mgosselin/gppr/images/scope_screen_captures/breadboard_prototype/raw_images/IMG_20190705_214928.jpg

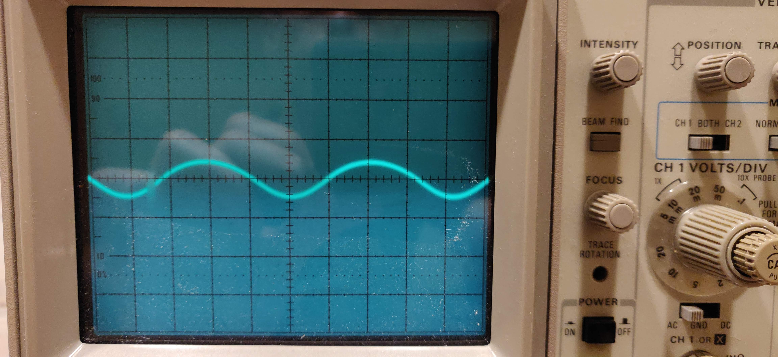
images/scope_screen_captures/breadboard_prototype/raw_images/IMG_20190705_214928.jpg
