mgosselin/gppr/images/lt_spice_screen_shots/circuit/Screen Shot 2019-07-04 at 11.34.25 PM.png

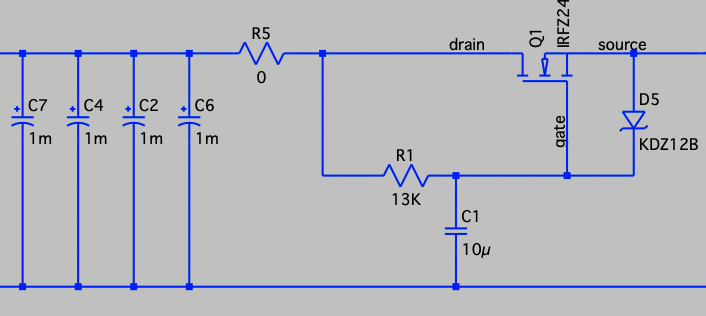
images/lt_spice_screen_shots/circuit/Screen Shot 2019-07-04 at 11.34.25 PM.png
