mgosselin/gppr/images/lt_spice_screen_shots/plots/spectrum_showing_all_freqs.png

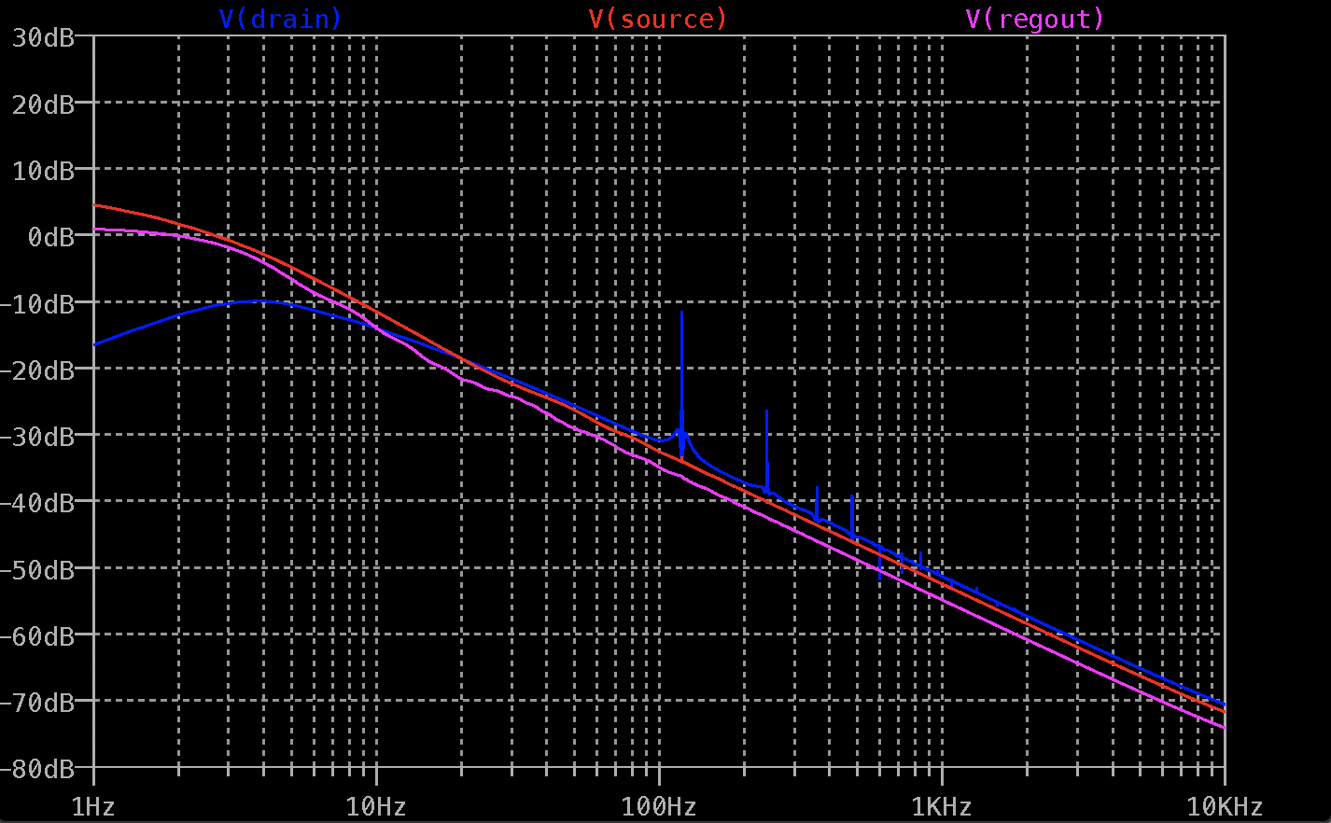
images/lt_spice_screen_shots/plots/spectrum_showing_all_freqs.png
