mgosselin/gppr/images/lt_spice_screen_shots/plots/spectrum_showing_harmonics.png

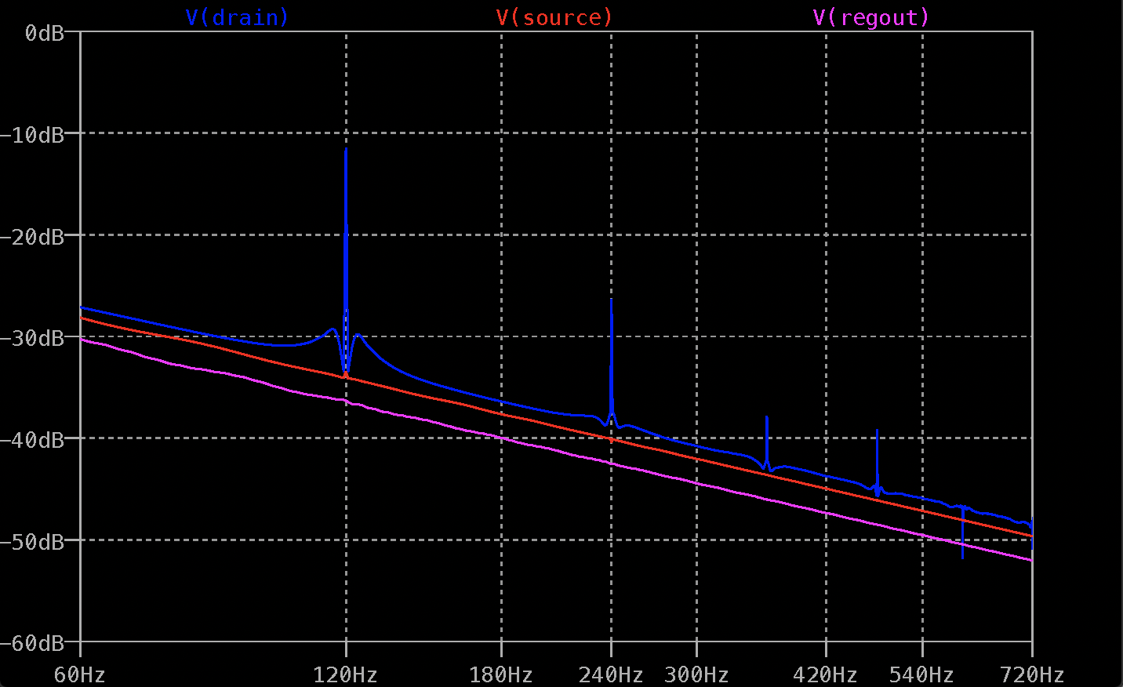
images/lt_spice_screen_shots/plots/spectrum_showing_harmonics.png
