mgosselin/gppr/images/lt_spice_screen_shots/plots/spectrum_showing_main_mode.png

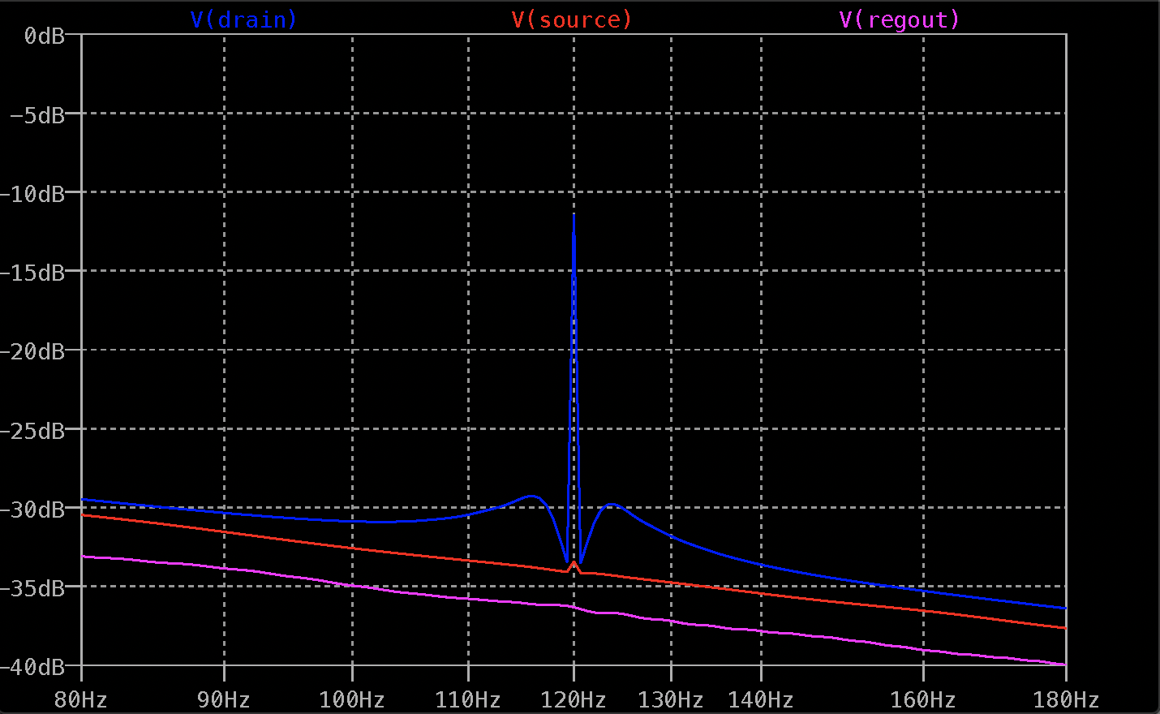
images/lt_spice_screen_shots/plots/spectrum_showing_main_mode.png
