mgosselin/gppr/images/lt_spice_screen_shots/plots/transient_all_nodes.png

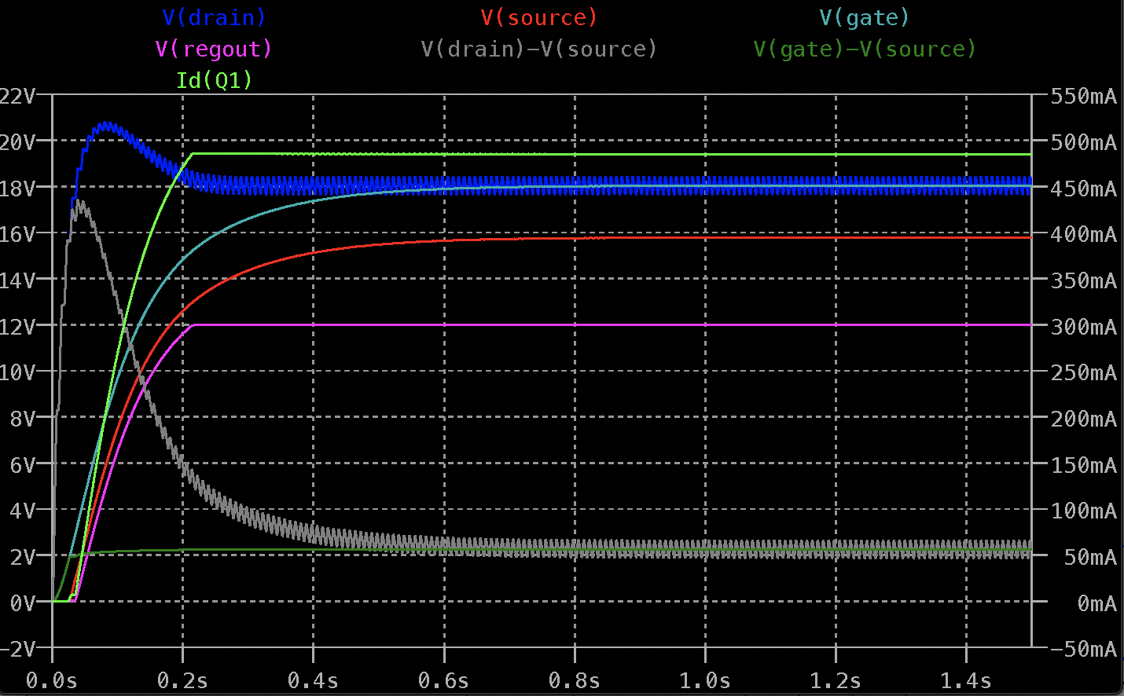
images/lt_spice_screen_shots/plots/transient_all_nodes.png
