mgosselin/gppr/images/lt_spice_screen_shots/plots/transient_drain_node_voltage.png

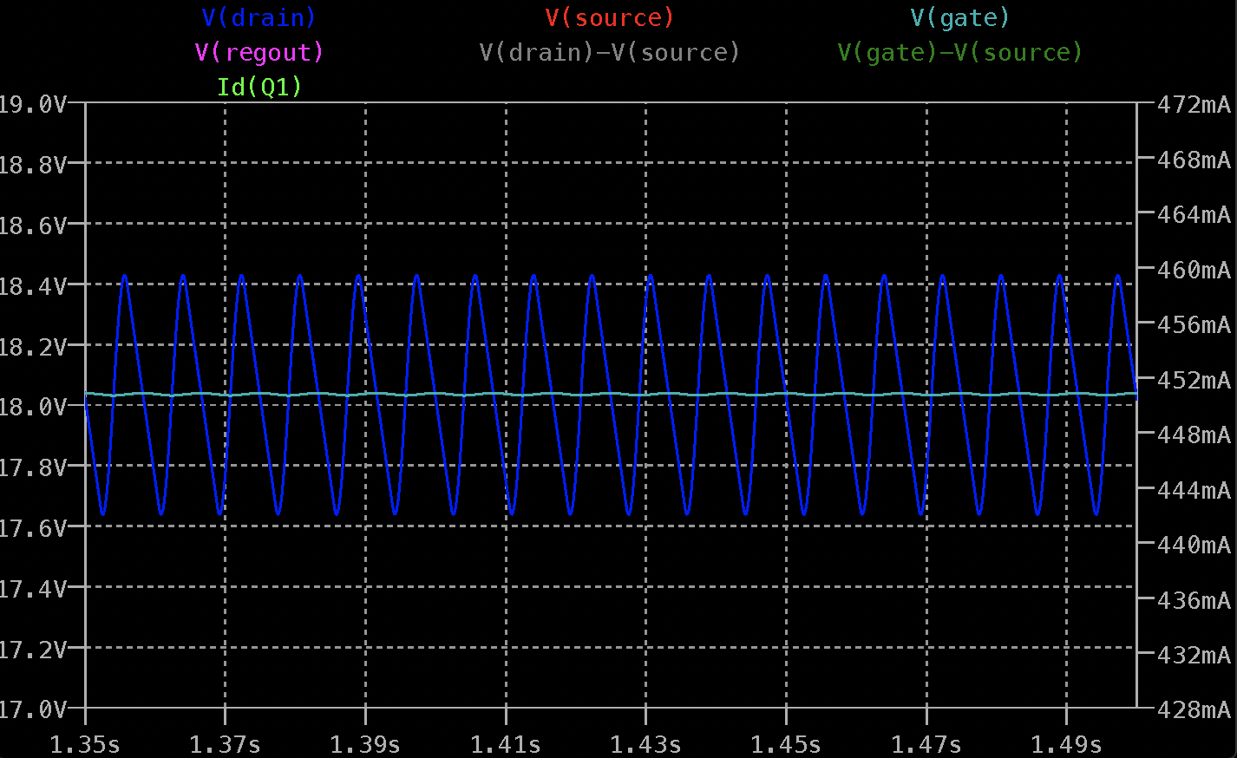
images/lt_spice_screen_shots/plots/transient_drain_node_voltage.png
