mgosselin/gppr/images/lt_spice_screen_shots/plots/transient_source_node_voltage.png

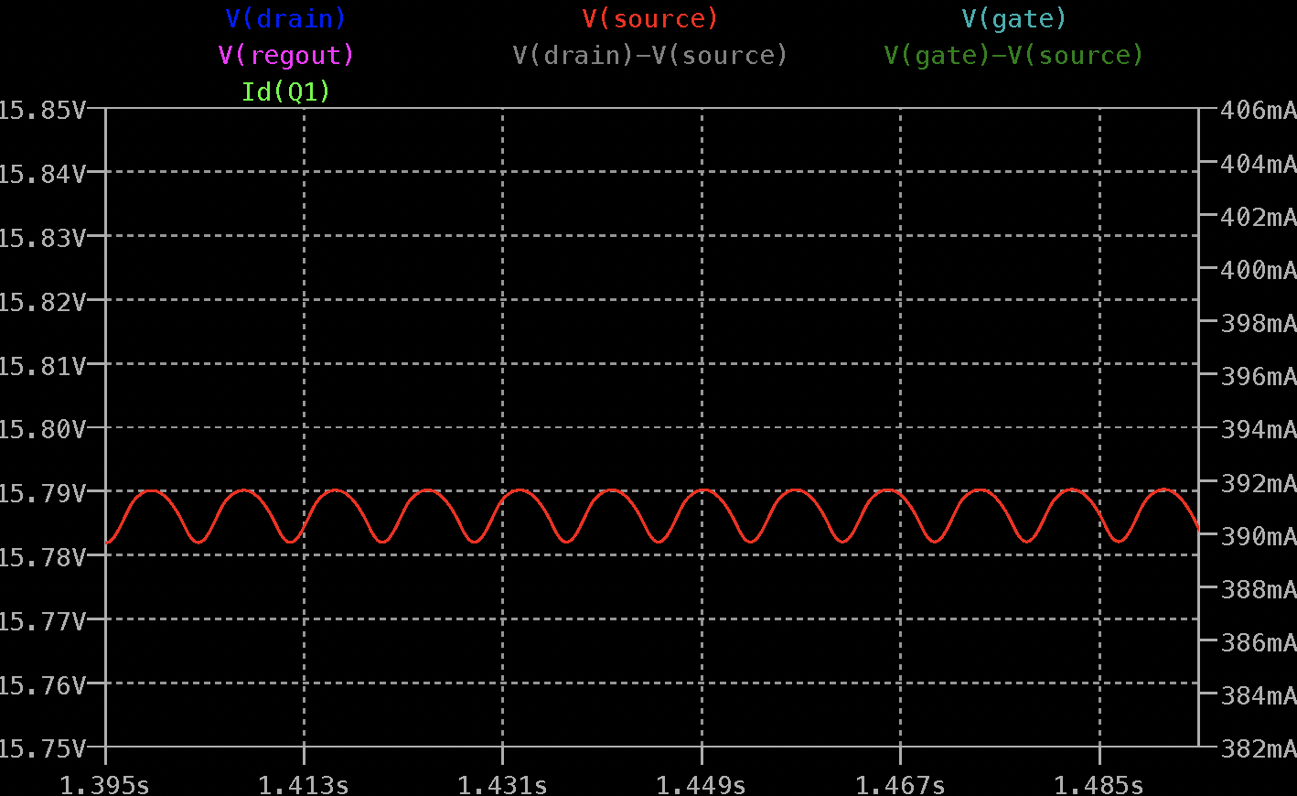
images/lt_spice_screen_shots/plots/transient_source_node_voltage.png
