mgosselin/gppr/images/scope_screen_captures/breadboard_prototype/drain_freq.png

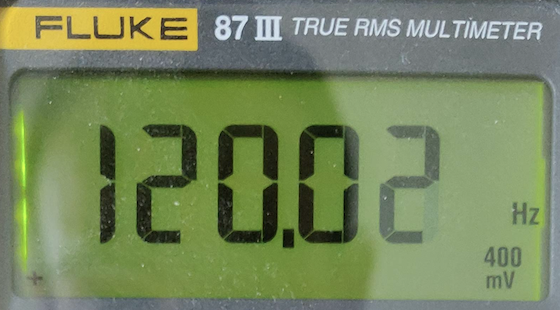
images/scope_screen_captures/breadboard_prototype/drain_freq.png
