mgosselin/gppr/images/scope_screen_captures/breadboard_prototype/drain_volt_ac_rms.png

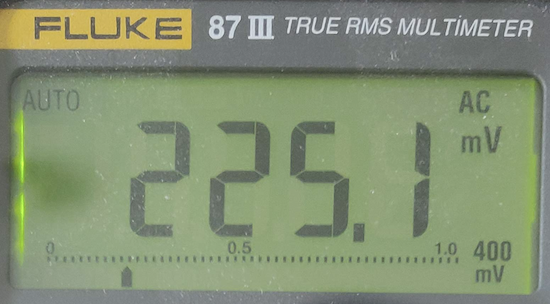
images/scope_screen_captures/breadboard_prototype/drain_volt_ac_rms.png
