mgosselin/gppr/images/scope_screen_captures/breadboard_prototype/drain_volt_dc.png

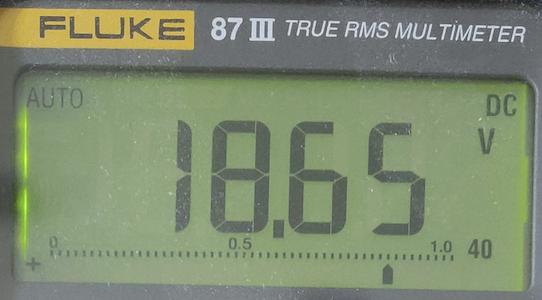
images/scope_screen_captures/breadboard_prototype/drain_volt_dc.png
