mgosselin/gppr/images/scope_screen_captures/breadboard_prototype/drain_volt_scope_trace.png

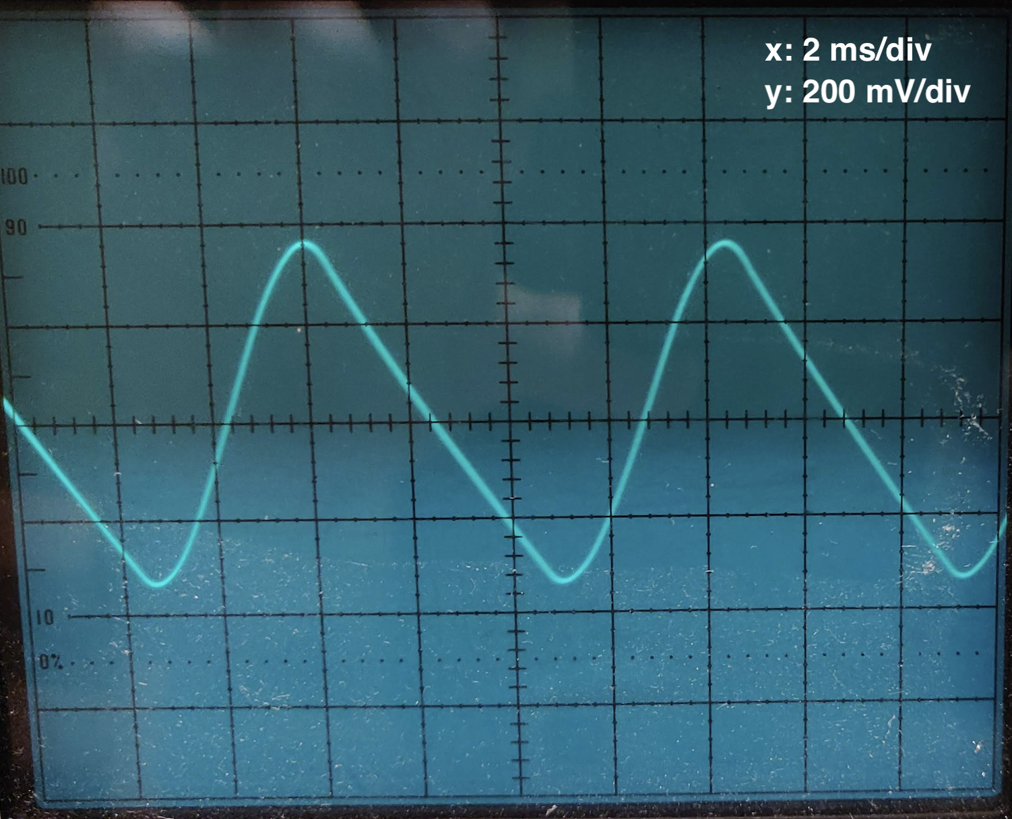
images/scope_screen_captures/breadboard_prototype/drain_volt_scope_trace.png
