mgosselin/gppr/images/scope_screen_captures/breadboard_prototype/load_current_dc.png

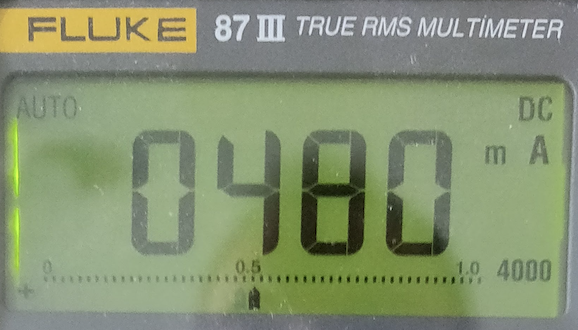
images/scope_screen_captures/breadboard_prototype/load_current_dc.png
