mgosselin/gppr/images/scope_screen_captures/breadboard_prototype/load_resistance.png

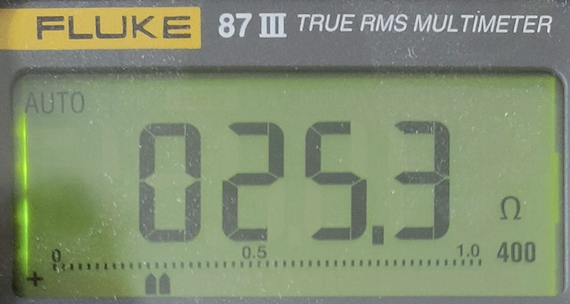
images/scope_screen_captures/breadboard_prototype/load_resistance.png
