mgosselin/gppr/images/scope_screen_captures/breadboard_prototype/load_volt_dc.png

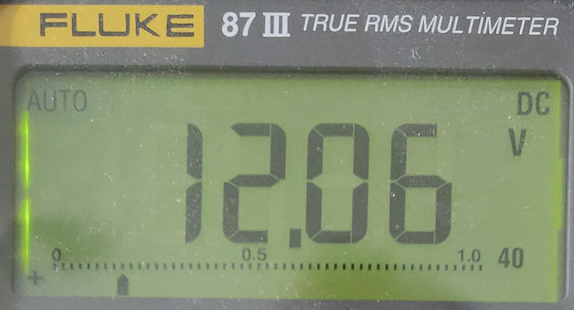
images/scope_screen_captures/breadboard_prototype/load_volt_dc.png
