mgosselin/gppr/images/scope_screen_captures/breadboard_prototype/raw_images/IMG_20190704_151019.jpg

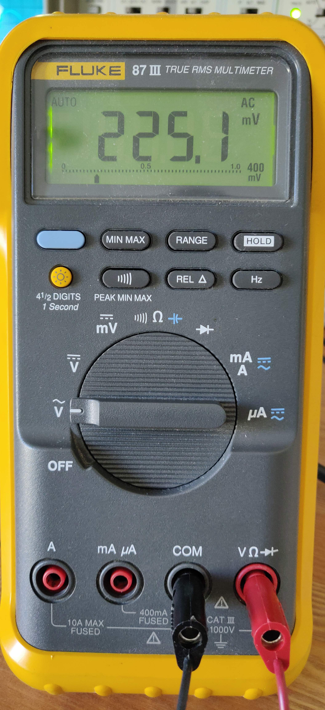
images/scope_screen_captures/breadboard_prototype/raw_images/IMG_20190704_151019.jpg
