mgosselin/gppr/images/scope_screen_captures/breadboard_prototype/source_freq.png

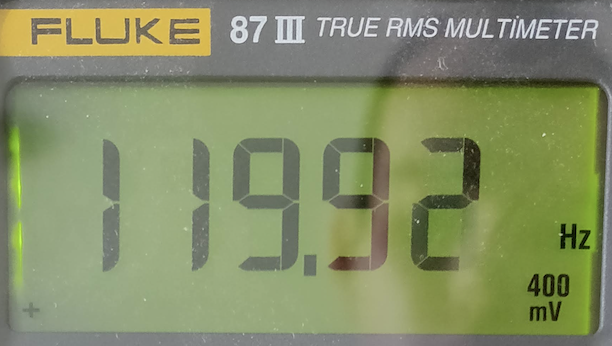
images/scope_screen_captures/breadboard_prototype/source_freq.png
