mgosselin/gppr/images/scope_screen_captures/breadboard_prototype/source_volt_ac_rms.png

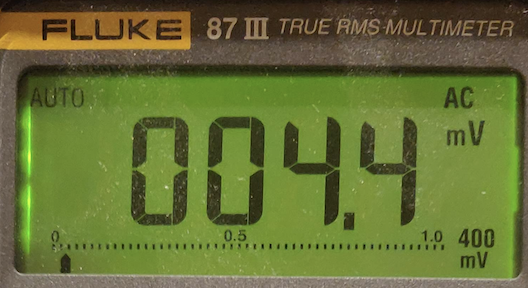
images/scope_screen_captures/breadboard_prototype/source_volt_ac_rms.png
