mgosselin/gppr/cad/gppr.kicad_pcb

## KiCad design cad/gppr.kicad_pcb (2019-08-31)

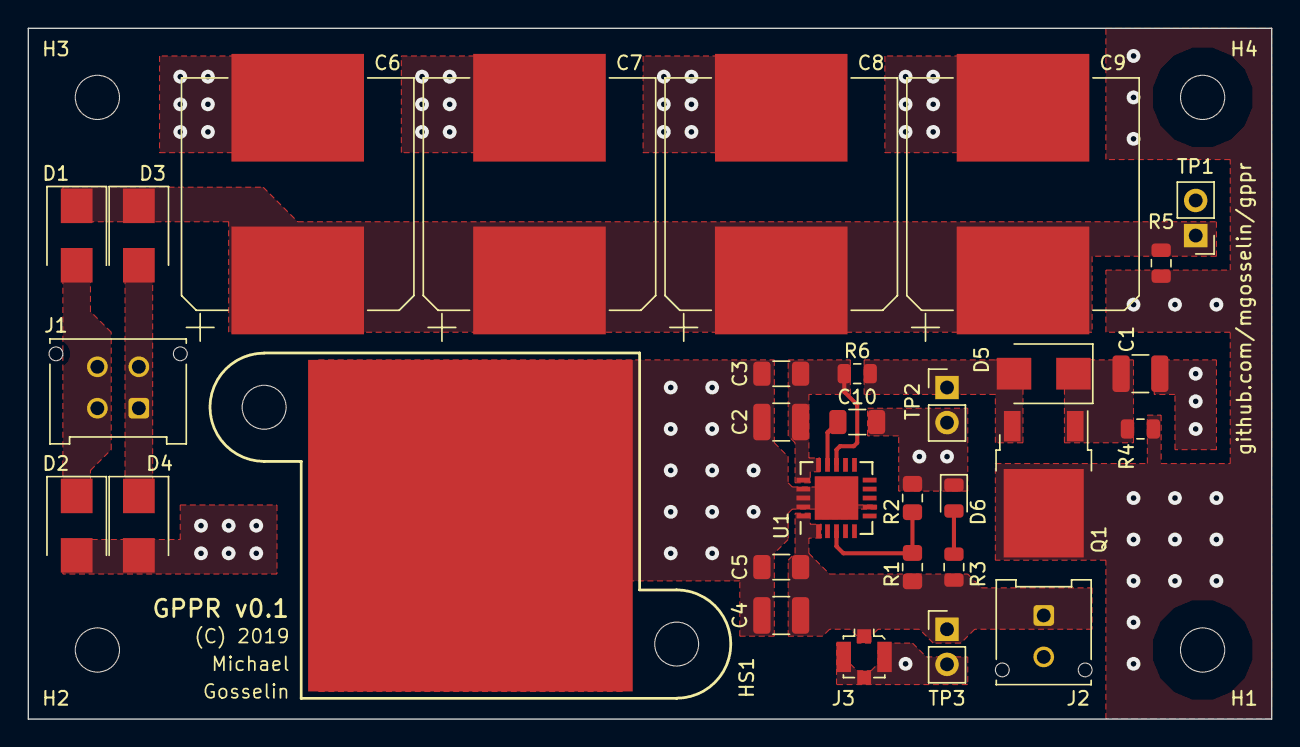
[picture p39: board gppr.kicad_pcb from above]

Board: 2 copper layers, 90.0 x 50.0 mm, 35 parts (0 on the bottom side), 12 nets.

Parts:
C1, C2, C4: 10uF; C_1210_3225Metric
C3, C5, C10: 1uF; C_1206_3216Metric
C6, C7, C8, C9: 1000uF; CP_Elec_16x17.5
D1, D2, D3, D4: MURS120; D_SMB
D5: 1SMB5927BT3G; D_SMB
D6: LED_POWER; LED_0805_2012Metric
H1, H2, H3, H4: MountingHole; MountingHole_3.2mm_M3_DIN965
HS1: Heatsink_Pad; Heatsink_960-23-XX-F-AB-0_Top
J1: Conn_01x04_Female; Molex_Micro-Fit_3.0_43045-0412_2x02_P3.00mm_Vertical
J2: Conn_01x02_Female; Molex_Micro-Fit_3.0_43045-0212_2x01_P3.00mm_Vertical
J3: Conn_Coaxial; U.FL_Molex_MCRF_73412-0110_Vertical
Q1: IRLR2908; TO-252-2
R1: 76.8KΩ; R_0805_2012Metric_Pad1.15x1.40mm_HandSolder
R2: 10.2KΩ; R_0805_2012Metric_Pad1.15x1.40mm_HandSolder
R3: 1KΩ; R_0805_2012Metric
R4: 13KΩ; R_0805_2012Metric
R5, R6: 0Ω; R_0805_2012Metric
TP1, TP2, TP3: TestPoint_2Pole; PinHeader_1x02_P2.54mm_Vertical
U1: TPS7A470X; Texas_VQFN-RGW-20

Connections:
GND: C1.2, C2.2, C3.2, C4.2, C5.2, C6.2, C7.2, C8.2, C9.2, C10.2, D2.2, D4.2, D6.1, HS1.1, J2.2, J3.2, R2.1, TP1.2, TP2.2, TP3.2, U1.7, U1.17, U1.18, U1.19, U1.21
unnamed: C1.1, D5.1, Q1.1, R4.1
unnamed: C2.1, C3.1, R6.1, U1.13, U1.15, U1.16
unnamed: C4.1, C5.1, J2.1, J3.1, R1.2, R3.2, TP3.1, U1.1, U1.20
unnamed: C6.1, C7.1, C8.1, C9.1, D1.1, D3.1, R5.2, TP1.1
unnamed: C10.1, U1.14
unnamed: D1.2, D2.1, J1.2, J1.4
unnamed: D3.2, D4.1, J1.1, J1.3
unnamed: D5.2, Q1.3, R6.2, TP2.1
unnamed: D6.2, R3.1
unnamed: Q1.2, R4.2, R5.1
unnamed: R1.1, R2.2, U1.3
