mgosselin/gppr/(commit log)

2019-07-08 create complete schematic
    [gppr.sch]
2019-07-08 update schematic: remove any-out, use resistor-divider fb on regulator instead
    [gppr.sch]
2019-07-08 add missing footprint references for in/out connectors
    [gppr.sch]
2019-07-09 add simple calcs for max input voltage for safe operation
    [gppr.sch]
2019-07-10 generate netlist
    [gppr.sch]
2019-07-10 remove .bak and greate .kicad_pcb file
    [gppr.kicad_pcb]
2019-07-10 un-track .DS_store
2019-07-10 remove .DS_store from /cad
2019-07-11 add jumper-resistors, change ceramic film capacitor packages
    [gppr.sch]
2019-07-17 basic component placement, prep for trace routing
    [gppr.kicad_pcb, gppr.sch]
2019-07-21 change heatsink footprint from bottom to top side
    [gppr.kicad_pcb, gppr.sch]
2019-07-22 reposition components, prep to route
    [gppr.kicad_pcb]
2019-08-31 route the board
    [gppr.kicad_pcb]
2019-08-31 generate gerber and drill files
    [gppr-B.Cu.gbr, gppr-B.Mask.gbr, gppr-Edge.Cuts.gbr, gppr-F.Cu.gbr, gppr-F.Mask.gbr, gppr-F.SilkS.gbr, gppr-NPTH.drl, gppr-PTH.drl]
