mgosselin/gppr/(notices)

Notices in the files:
cad/gppr.kicad_pcb:
(C) 2019
